Zhongy1/LaserTag/Images/Prototype1/CAD/blaster_print_1.jpg

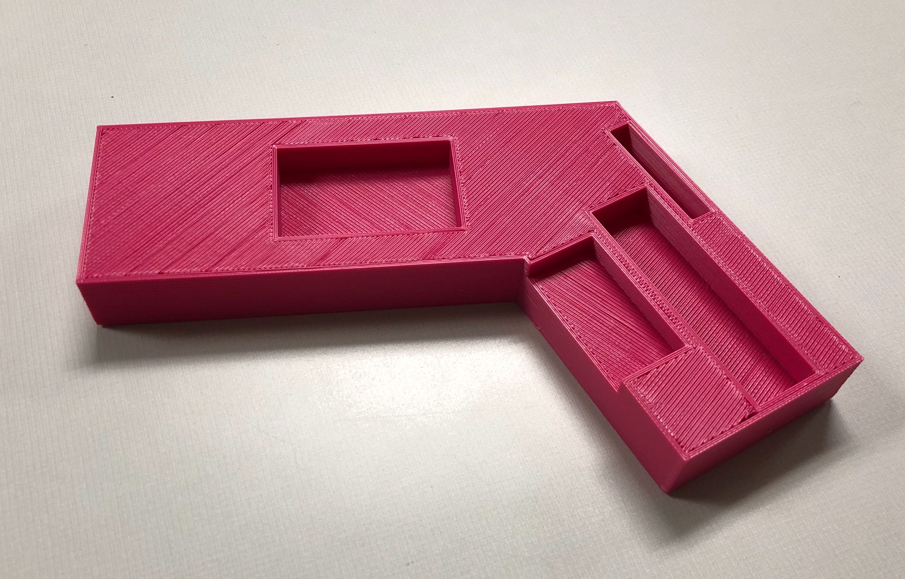
Images/Prototype1/CAD/blaster_print_1.jpg
