Zhongy1/LaserTag/Images/Prototype1/Arduino/wiring.jpg

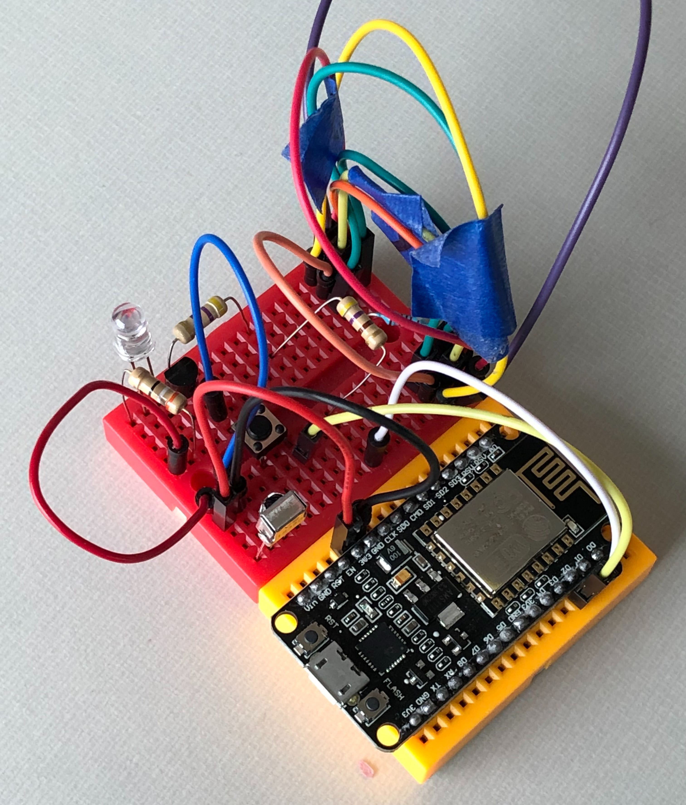
Images/Prototype1/Arduino/wiring.jpg
