Zhongy1/LaserTag/Server/README.md

# Laser Tag Server

> Server component of laser tag system

## Running the server

```bash
# Open a new terminal, install dependencies and run the backend server
$ cd LaserTag/Server/Backend/
$ npm i
$ npm run prod

# Open a new terminal, install dependencies and start serving the frontend
$ cd LaserTag/Server/Frontend/
$ npm i
$ npm run serve
```
