Zhongy1/LaserTag/Server/Frontend/README.md

# Laser Tag Server Frontend

> Web client component of laser tag system

## Project setup
```
npm install
```

### Compiles and hot-reloads for development
```
npm run serve
```

### Compiles and minifies for production
```
npm run build
```

### Customize configuration
See [Configuration Reference](https://cli.vuejs.org/config/).
