Zhongy1/LaserTag/Prototype1/Server/README.md

# LaserTag Server

Laser tag server for scoreboard and game functionality
