Zhongy1/LaserTag/Images/Prototype1/CAD/blaster_half_1.png

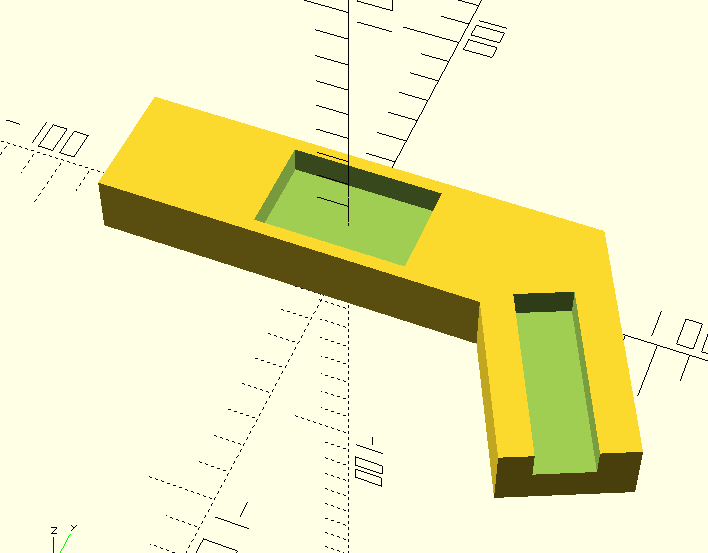
Images/Prototype1/CAD/blaster_half_1.png
