Zhongy1/LaserTag/Images/Prototype1/Circuitry/battery_contacts.jpg

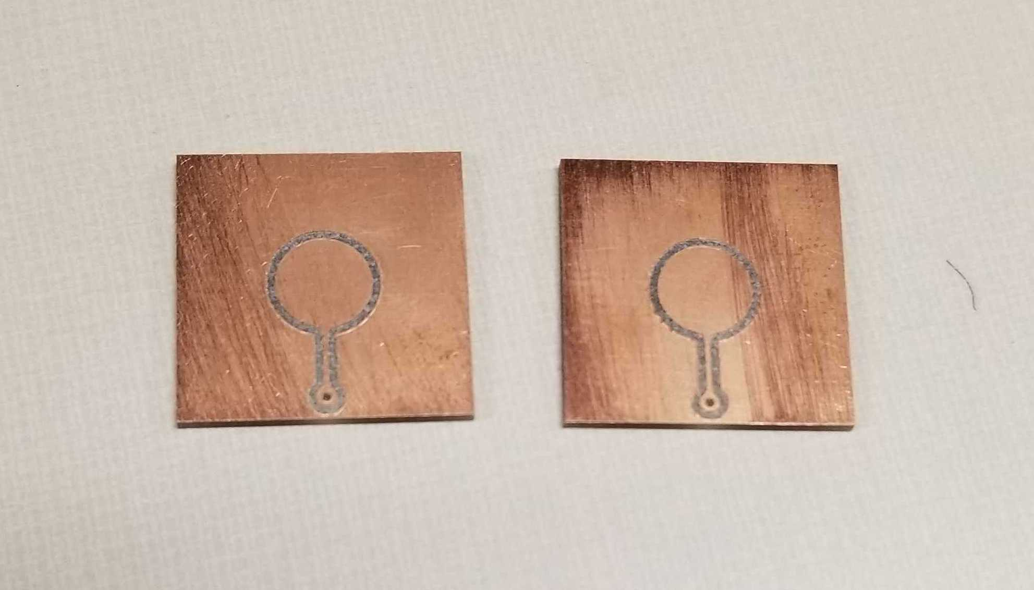
Images/Prototype1/Circuitry/battery_contacts.jpg
