Zhongy1/LaserTag/Images/Prototype1/Circuitry/battery_contacts_boards.jpg

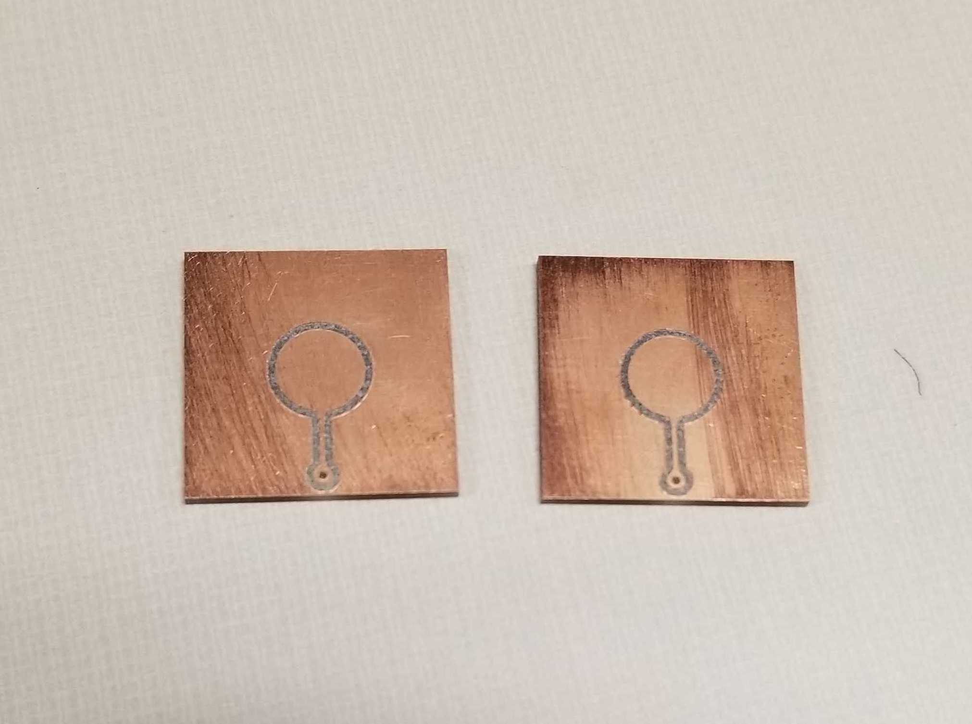
Images/Prototype1/Circuitry/battery_contacts_boards.jpg
