Zhongy1/LaserTag/Images/Prototype1/Circuitry/battery_contacts_design.png

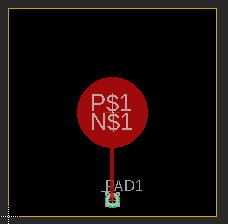
Images/Prototype1/Circuitry/battery_contacts_design.png
