Zhongy1/LaserTag/Images/Prototype1/Circuitry/control_board_bottom.jpg

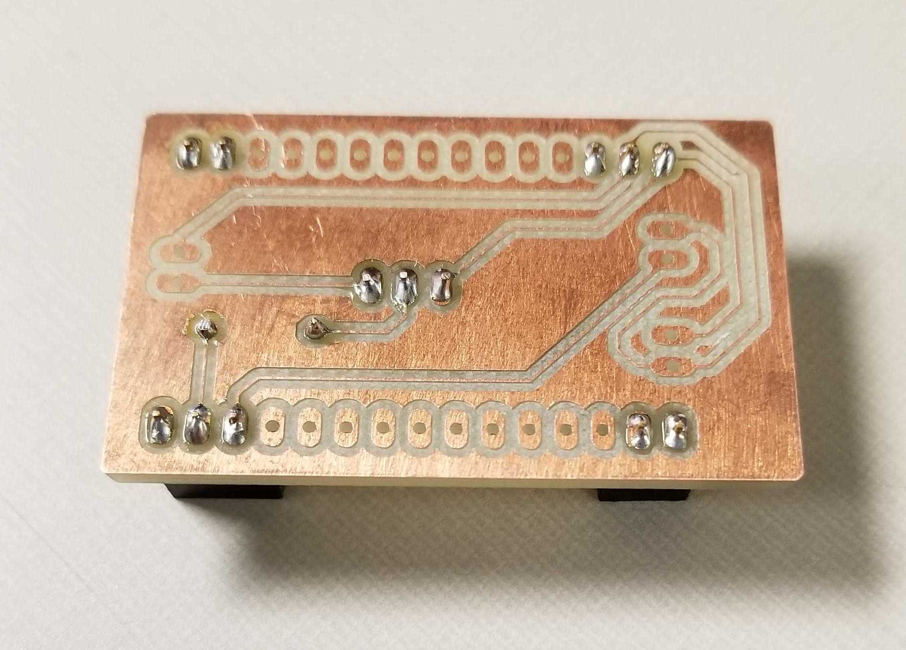
Images/Prototype1/Circuitry/control_board_bottom.jpg
