Zhongy1/LaserTag/Images/Prototype1/Circuitry/control_board_top.jpg

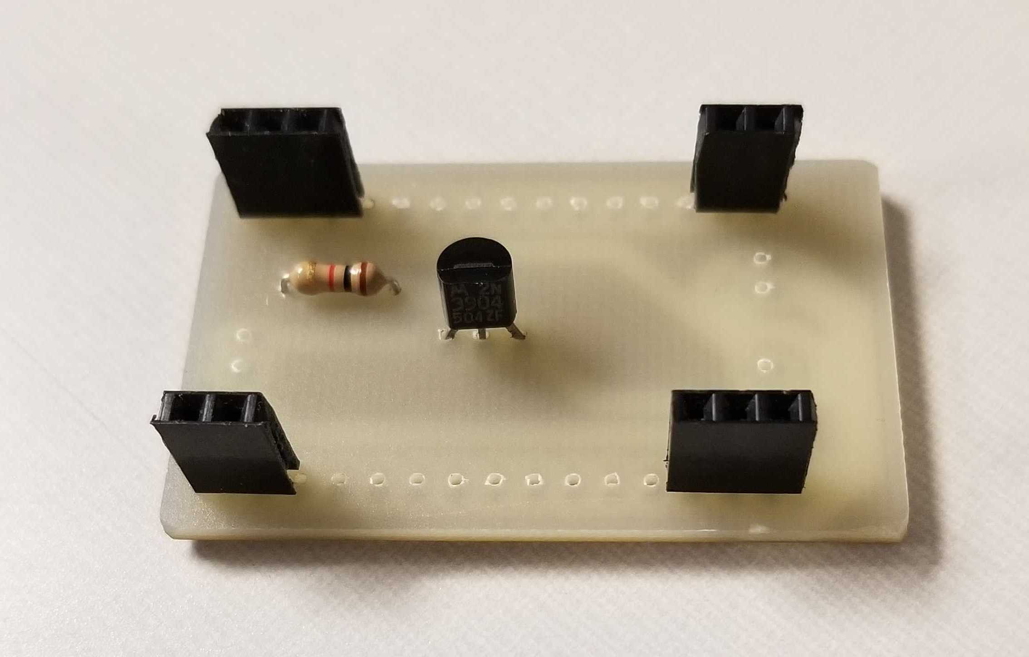
Images/Prototype1/Circuitry/control_board_top.jpg
