Zhongy1/LaserTag/Images/Prototype1/Circuitry/ctrl_board_design.png

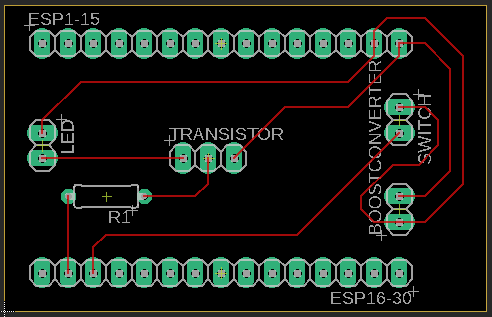
Images/Prototype1/Circuitry/ctrl_board_design.png
