Zhongy1/LaserTag/Images/Prototype1/Circuitry/led_board_design.png

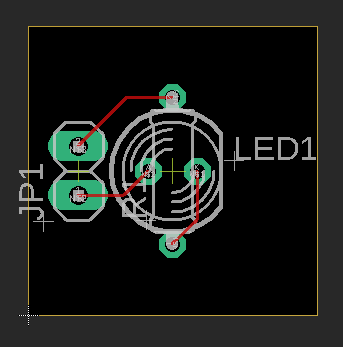
Images/Prototype1/Circuitry/led_board_design.png
