Zhongy1/LaserTag/Images/Prototype1/Circuitry/led_red.jpg

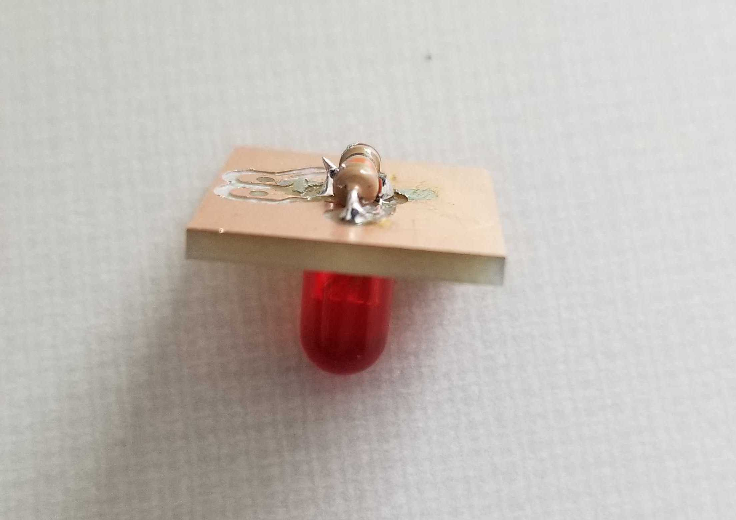
Images/Prototype1/Circuitry/led_red.jpg
