Zhongy1/LaserTag/CAD/LensTachment.scad

use <base_modules.scad>


lensDiam = 19.9 + 0.4;
lensDiamInner = 17.62 + 0.4;

Attachment();
//Attachment([0, -40, 0]);
//Attachment([0, 40, 0]);
*for (i = [0 : 4]) {
    translate([i * 20, 0, 0])
        solid_block([10, 10, 10]);
}

module Attachment(shift = [0, 0, 0], rotation = [0, 0, 0]) {
    translate(shift) { rotate(rotation) {
    
    
    intersection() {
        difference() {
            translate([30, 0, 0])
                //cutout to attatch onto gun
                solid_block([60, 40.43 + 5, 55.29 + 5]);
            translate([5, 0, 2.5])
                solid_block([10, 40.43, 55.29]);
            translate([0, 0, (55.29 + 5)/2])rotate([0, 90,0])
                solid_cylinder([lensDiamInner, lensDiamInner , 60]);
            for (i = [0 : 9]) {
                translate([i * 6 + 12, 0, (55.29 + 5 - lensDiam)/2])
                    //remeasure slit for lens
                    solid_block([1.09 + 0.3, lensDiam, lensDiam]);
            }
        }
        translate([30, 0, 0])
            solid_block([60, 40.43 + 20, (55.29 + 5)/2]);
    }
    
    
    }}
}
