Zhongy1/LaserTag/(threads)

Thread 1 (2019-09-23):

P1 | CAD | Initialize design

Zhongy1, 2019-09-23:
Use hypothetical values to temporarily generate the shape of the blaster as well as hollowed regions where parts will go. Follow the sketch design attached.
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

Zhongy1, 2019-09-30:
Keep in mind that this is just initialization. The placement of objects can be approximated, any rotations for certain items can be ignored, and rectangular or complex cutouts can even be square cutouts near the area it has to be. Focus on just the bottom half of the blaster; see if you can create a simple design presentable at our next team meeting.

Closed 2019-10-28.

Thread 3 (2019-09-25):

P1 | Circuitry | Microcontroller board

Zhongy1, 2019-09-25:
Start working on adding components to microcontroller.sch. Most of the components should just be adding two/three pin holes. For the ESP8266, use two rows of pin holes. For the board file, follow the general layout at the bottom of the image. Don't worry about where things are connected just yet. There may be some syncing issues with the schematic and board file. Message me directly if this is the case.

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

Closed 2019-10-22.

Thread 4 (2019-09-25):

P1 | Arduino | IR LED Test Circuit

Zhongy1, 2019-09-25:
Demonstrate IR LED functionality works with transistor as signal controller.
- Creating IR LED circuit (possibly follow the image attached, use resistor values as shown as well)
- Create receiver circuit to collect the signal from IR LED and verify that it is correctly sending

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

Closed 2019-11-19.

Thread 8 (2019-09-30):

P1 | Arduino | Understanding Websocket

Zhongy1, 2019-09-30:
websocket_example has been added to the Arduino folder. It's a bit short, so figure out what is happening by the end of the week. You do not need to create a branch for this issue since you don't need to modify or add anything. Do some planning on how websocket can be incorporated into the blaster. For example, if IR receiver detects a signal that should be sent to the server, how would you do that?

Thread 12 (2019-10-18):

P1 | CAD | Simplified design

Zhongy1, 2019-10-18:
Assuming that the general cutout regions have been created, it is time to modify the frame and cutout regions using actual values. The goal is to create a design that can house all of the components necessary for a working prototype: microcontroller, IR LED, switch, boost converter, and battery.
- Do not attempt to create detailed cutout regions, that task will done in a future issue.
- Keep cutout regions rectangular.
- You will have to print your design to actually show that everything fits.

Add more variables as needed. These will be filled in/modified overtime when measurements are collected. These variables go into Variables.scad.
Variables: (In millimeters)
- circBrdT = 0; //TBD
- circBrdSolderSpace = 3;
- ledBrdW = 10;
- ledBrdL = 10;
- ledHousingD = 5.4;
- ledHousingH = 0; //TBD
- microCtlrHousingW = 0; //TBD
- microCtlrHousingL = 0; //TBD
- microCtlrHousingH = 0; //TBD
- switchHousingW = 0; //TBD
- switchHousingL = 0; //TBD
- switchHousingH = 0; //TBD
- cnvrtrHousingW = 0; //TBD
- cnvrtrHousingL = 0; //TBD
- cnvrtrHousingH = 0; //TBD
- batteryHousingW = 0; //TBD
- batteryHousingL = 0; //TBD
- batteryHousingH = 0; //TBD

GunPieceBottom:
- create sub-modules for each cutout (i.e ctlrCutout, switchCutout, etc.). Doing this will make adding details easier in the future.
- call the sub-modules here; since the general cutout locations are established, all you might need to do is replace a few lines of code with ctlrCutout, switchCutout, etc.
- you will be using difference() here. Since the first item for difference is the thing you subtract from, use union() to gather pieces together first (i.e the frame of the gun)
- adjust size of gun overtime; use a variable to make changing the size easier if needed
- keep in mind that this is half of the gun, which means you will only be using half the housing heights. The other half of the height goes to GunPieceTop

GunPieceTop:
- If done right, you should be able to use the mirror of GunPieceBottom
- No need to worry about locking the top and bottom together, that can be done in another issue

fdemp, 2019-10-30:
Microcontroller board + ESP8266 has a height of 17.4mm

Closed 2019-12-31.

Thread 13 (2019-10-18):

P1 | Circuitry | Microcontroller board component connections

Zhongy1, 2019-10-18:
Now that all components have been added to the schematic and pieces can be moved around on the board file, it's time to connect everything and cutout a board.

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

Use the general layout of the board from issue #3.
- B: Two wire holes to +/- to boost converter board (B1, B2)
- L: Two wire holes to IR LED board (L1, L2)
- T: Three holes for transistor legs (T1, T2, T3; T2 is the middle hole)
- S: Two wire holes to switch/trigger (S1, S2)
- New R: Two wire holes for resistor (R1, R2)

Since everything is just holes, order does not matter as wire positions can be swapped or transistors can be rotated.
Create the following connections:
- B1 to GND
- B2 to Vin
- L1 to T1
- L2 to GND
- T2 to R1
- R2 to D1/GPIO5 (This is for switching on/off transistor)
- T3 to Vin
- S1 to D2/GPIO4 (This is for detecting pulled trigger)
- S2 to GND

Since there's no circuit drawing this time, there will likely be some confusion. Post questions onto this issue and I will address them. The layout is still similar to drawn layout from #3, but is actually wrong because it did not account for how the microcontroller board will be mounted. The GND and Vin pins are actually mirrored on your board file because the top is where you will solder. Once done, let me know so we can cut the board.

Closed 2019-10-22.

Thread 14 (2019-10-18):

P1 | Arduino | Send IR signals using ESP8266

Zhongy1, 2019-10-18:
It has been demonstrated that sending IR signals from the Arduino Uno works. Now it's time to do the same with the ESP8266. The library used on the Uno is different from the one that will be used for the ESP8266; a little bit of googling will give you an idea of what library to use. Do the following:

Create IR_ESP8266.ino in the Arduino folder; use this file to write the code to test sending/receiving signals.
- Create a function called emitHex which takes a hexadecimal string as input.
  - The only thing this function should do is cause IR LED to emit a signal
  - This function seems unnecessary, but in the future, this function will be modified to take an object/list of information and convert them into hex format to be emitted.
- A microcontroller should be able to both receive and send signals
- Use a transistor to control the LED, as this is what will be in the actual circuit
- An Arduino Uno can still be used as the receiver; to test at a distance

For the prototype, one microcontroller will control the receiving of signals and send information to the server. The other one will be inside the gun and it will control the sending of signals. Both microcontrollers will need to be connected to the server, but for this issue you don't need to worry about doing that. Once everything here works, assume that you will be copying code over to blaster_client and receiver_client.

torashad99, 2019-10-23:
Added IR_ESP8266 file and created function prototype for emitHex function

Zhongy1, 2019-10-25:
Use D1 as sender, D2 as switch, D3 as receiver

Closed 2019-11-19.

Thread 15 (2019-10-18):

P1 | Arduino | Establish Websocket connection

Zhongy1, 2019-10-18:
Connecting ESP8266 to an access point is now possible. Previously, we encountered a problem because ESP8266 can only connect to WPA/WPA2 type access points, but UIC's network is WPA Enterprise. The current solution to this problem is to use a linux machine to create a WPA2 type access point to which the microcontroller will connect to. We will create a file that will focus primarily on communicating with the server.

Create a file called receiver_client.ino in the Arduino folder, this will be the official file to use for the IR receiver microcontroller.
- A lot of the code can already be taken from websocket_example.ino
- Assuming you do use the code from the example, create a function called sendHexToServer which takes a string as an argument
  - For now, this function can execute one line which is to just send a string to the server
  - In the future, some string manipulation may be necessary but you don't need to worry about that

For testing your code, contact me on how to do it. Creating an access point from ArchLinux is really simple, not sure how same that is for other linux operating systems.

Closed 2019-10-25.

Thread 19 (2019-10-29):

P1 | Circuitry | Solder components to microcontroller board

Zhongy1, 2019-10-29:
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

Do the following:
- Solder female header pins to regions marked in red
- Solder a 1K ohm resistor in region marked in green
- Solder a transistor into the region marked in blue, match the legs with the labels

All components should be inserted from the opposite side. Which means there should be no components on the copper side

jmossm2, 2019-10-29:
Soldered the components to the board
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

Closed 2019-10-29.

Thread 20 (2019-10-29):

P1 | Circuitry | LED board

Zhongy1, 2019-10-29:
Create a circuit board that fits a 5mm LED. Use the following schematic as a guide:
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

Create a schematic file called led.sch. Its corresponding board file should automatically be named led.brd.
For the board, use 15mm by 15mm as the dimension; you will be fitting components into a square board. The LED should be centered directly in the middle of the board. Sticking with the metric system, it's coordinates should be at x: 7.5mm and y: 7.5mm. The pin header should be placed at the center of one side. It may be possible to place the resistor directly in the center by overlapping LED and resistor.

Closed 2019-10-29.

Thread 25 (2019-11-01):

P1 | Circuitry | Battery Contacts

Zhongy1, 2019-11-01:
We now have boards for LED and microcontroller. The last boards to work on are the contacts for the battery. The following drawing will give you an idea of what you will be creating.

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

I have added custom_library.lbr to the Circuitry folder. Search up how to add a library to Eagle. In it contains a few things, but you will only be using CONTACT_REGION. This a a circular pad that you can put solder on to form the contacts for the battery. An example of how the board will be laid out is shown in the drawing; it includes the pad as well as a hole for a wire to go through.

The bottom two drawings show where the circuit board will be placed in the holder. You can notice that the width/length of the board will be greater than the diameter of the battery.

For the file name, use battery_contact.

Closed 2019-11-05.

Thread 28 (2019-11-19):

P1 | Circuitry | Microcontroller board connection modifications

Zhongy1, 2019-11-19:
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
The connections specified in issue #13 does not work. Fortunately, this is a simple fix.
Modify microcontroller.sch to reflect these changes:
- LED pin 1 to Vin (ESP1-15 pin 15)
- Transistor pin 3 to GND (ESP1-15 pin 14)

Modify microcontroller.brd to correct the wire paths.

Closed 2019-12-31.

Thread 33 (2020-01-21):

P2 | Circuitry | Battery Insert

Zhongy1, 2020-01-21:
The plan for prototype two is to create a battery case that can attach to or detach from the blaster. Think of this as the magazine for a gun. The purpose of this is to eliminate the need to put a blaster on standby just for it to charge. This task will involve doing some CAD work to create a prototype for the battery insert. Design does not need to look good. Since this is a prototype, show that this idea is actually possible first before planning for actual designs for the battery case.

Battery contacts were created for prototype one. Evaluate if a new design should be used or if any modifications can be made to improve the board. For example, maybe the board could be smaller.

Some other important things:
- You will be doing some wiring; you may need to create wire paths in your CAD design
- Pay attention to short circuits or plugging into wrong terminals; how to avoid setting battery on fire

Components possibly needed:
- tp4056; charge circuit
- boost converter
- male/female header pins

Thread 34 (2020-01-21):

P2 | Circuitry | Battery Charging Station

Zhongy1, 2020-01-21:
Since we are designing detachable battery packs, a charging station would be an ideal complement. Just like the Battery Insert #33, CAD is involved. The station is not necessary for this prototype, but by designing it, it may give insight about how to design the battery socket for the blaster. The station does not have to be big, maybe the first one could just be for one battery.

Components available to use:
- tp4056; charge circuit
- 5 volt power supply

Thread 35 (2020-01-21):

P2 | Circuitry | RGB LED Testing

Zhongy1, 2020-01-21:
To indicate who is in which team, we decided to use RGB LEDs on the side of the blaster. Create boards that could be mounted onto a breadboard for a programmer to use. Each LED will be individually addressable. Multiple shift registers (74hc595) will be used. Start with two; it'll give you an idea on how they can be chained together.

Parts to use:
- Common anode smd 3528 RGB LEDs
- 0805 smd resistors (330 ohms)
- 74hc595 shift register

Notes:
- Common anode LEDs share the same positive connection
  - To set an LED as operational, set this connection to HIGH; LOW otherwise
  - The other connections will be controlled by three pins from the microcontroller, whether or not transistors are needed here will be determined later on. The current output for a pin on ESP8266 is 12ma. Keep in mind that LEDs can take up to 20ma and that the pin current might be shared by all the LEDs on the board.
- The shift register we are using can supply HIGH output to 8 LEDs
- In total, 6 microcontroller pins are needed to ideally control any number of LEDs
- This will most definitely by a double sided board

Thread 36 (2020-01-23):

P2 | NodeJS | Back and Front End Implementation

Zhongy1, 2020-01-23:
Now that a prototype for a blaster as well as a basic sensor node is ready and usable, all features for the server can be implemented with minimal reliance on the other sub teams.
This is the list features to implement server side:
- Waiting room
- Game rooms
- Teams
- Scoring System / Kill counter
- Game time tracker

This is the list of features to implement web client side:
- Waiting room display
- Game room creator
- Team selector
- Game stats display

Connecting microcontrollers:
Two types of nodes will be connecting directly to the server: blaster and sensor vest. Each node will have it's own unique ID preset to something of our choosing. Example: "B01" or "B02" for blaster and "S01" or "S02" for sensor vest. These ID's will be shown in the web client to allow easy placement into teams. Immediately upon joining, nodes will be placed into the main waiting room where they will become visible in the front end.

The following are more details on each of the features. Will include possible implementation and what kind of properties might be needed if a class should be made.

**Nodes**
Create a general class for a node; as well as two more classes for blaster and sensor vest which will extend off the this class. Common properties may be ID or a companion ID to indicate which node it should be associated with. Blaster/vest node can include a set function which ensures that companion ID can only be "S" or "B" respectively. One more possible common property could be a reference to the websocket the node is associated with (more about this later, ask me about this part).

**Waiting Room**
Class with possible property to include: nodes list, could be an array or a mapping that can hold both blaster and vest.

**Game Room**
Class with possible properties: room ID, list of Team objects. When moving a node into a game room, decide on what may be best. Have nodes auto join first available team initially? Have each node be put into a new team upon joining? Should a room size be used? Maybe a property to enable/disable free for all?

**Teams**
Class with possible properties: blaster/vest node list (separate?), team color in HEX. Team color will be given to blaster to set RGB LED colors. Vest nodes will not need the color. They will process attacks from blasters and it will be for the server to decide if target is eliminated or not if on same team. Purpose for this is sensors may pick up incorrect signals maybe from the game environment and end up disabling itself when it's not supposed to. The server should check that the attacker actually exists in the same game room.

**Scoring System**
This could be incorporated into game room functionality. Property to add then include most kills (and by who). Other stats to track could be decided later.

**Game Time Tracker**
Not really needed/important, but it'd be nice to keep track of how long game is running. Could be implemented in Game Room.

**Front End**
Figure out a way to layout the webpage to display the information about the server. I highly suggest using websockets for this to provide webpage with live updates. I can teach you how websockets work if needed.

**Node communication with server**
Before we were using commands sent over websocket to do various things. I still think this is a good idea. Blasters will likely not be sending any information to server besides ID. Only the vest nodes will be sending data in a command of this format: `/attack <attacker> <victim>`. Example: `/attack B01 S02' which means blaster with ID 'B01' attacked vest with ID 'S02'. Some other things to look out for...

Not okay (considered invalid and will be ignored):
- `/attack S01 S02` Vest attacking vest
- `/attack B01 B02` Blaster attacking blaster
- `/attack S01 B02` Vest attacking blaster
- Blaster attacking vest of same player; check companion ID of blaster node

May not be okay (could be invalid; depends on if ID exists):
- `/attack B74 S01` B74 is suspiciously big, but if it exists in game room then attack is valid

Connect command format:
- `/connect <node-id>` Create a new node object of type blaster/vest using the provided ID

Thread 40 (2020-01-27):

P2 | CAD | Lens Testing Attachment

Zhongy1, 2020-01-27:
For prototype one, we did not use a lens with our IR LED. We want to design a module that can be attached to prototype one to test IR LED with lens.

Closed 2020-03-09.

Thread 41 (2020-01-28):

P2 | Arduino | Send Raw IR Signals

Zhongy1, 2020-01-28:
Currently prototype one sends an NEC signal. This can potentially interfere with LG TV's. We would like to use the send raw signal functionality built into the same IREsp8266 library. Create a new Arduino file that can be uploaded to the prototype blaster to test outputting raw signals. To receive, one of the examples for receiving signals that comes with the library should work.

Thread 42 (2020-01-28):

P2 | Arduino | Ammo Tracking Functionality

Zhongy1, 2020-01-28:
We had planned to implement ammo functionality for a while. This is the time to do that. For now we can hard code how much ammo is in a blaster. Maybe 8 is a good number. Each time the trigger is pulled, --ammo--++. There also needs a delay before the next shot can be made. Avoid using Arduino's delay function as that prevents other functionalities from running. To reload, hold down the trigger for 3 seconds. After three seconds, the blaster is reloaded and can output IR signals once again.

awoo8, 2020-02-18:
This is also addressed in #52 and is completed in #54

Closed 2020-02-18.

Thread 49 (2020-02-03):

P2 | CAD | Round Out Blaster

Zhongy1, 2020-02-03:
Currently prototype one is just a block. It's very uncomfortable to hold. We want to round out the edges for prototype two. Create a mock file to represent just the potential shape of prototype two. This means you can use arbitrary values instead of the values from variables.scad. Finally, design this such that it is lying on its side just like prototype one.

Call this file p2shape.scad.

Thread 51 (2020-02-11):

P2 | Circuitry | Control Board

Zhongy1, 2020-02-11:
New pins used:
Trigger -> D0
Oled SCL Pin -> D1
Oled SDA -> D2
Infrared LED -> D3
Shift Register Data Pin (14) -> D4
Shift Register Clock Pin (12) -> D5
Shift Register Latch Pin (11) -> D6
LED Red Control -> D7
LED Green Control -> D8
LED Blue Control -> TX
Battery Checker -> A0

This prototype we will be using the majority of the pins on the ESP8266. Features we will support are infrared output, trigger pull detection, OLED display, LED light display, battery checking. This means we will need to create test cases for each of these features...
- Trigger and infrared LED. (Only the pins changed, so could possibly modify an exiting test case)
- Reload functionality
- OLED (Write letters and/or numbers on screen)
- Shift register and various color test
- Battery checker
There will be issues for each of these. More information will be on each of those issues.

The creation of the main board will depend on how things turn out in each of the test cases. For example, guides online advise us to use pull up resistors on the SCL/SDA pins. May or not be necessary; if it works without resistors then we won't add resistors. Some other various things to include:
- resistor for a transistor
- resistor(s) for IR LED (SMD resistor)
- resistors for red/green/blue control pins (SMD resistors)
- resistor for battery checking (maybe)

Closed 2020-03-03.

Thread 53 (2020-02-17):

P2 | CAD | Initialize Individual Files

Zhongy1, 2020-02-17:
For prototype one, we created modules for led, main board, battery, etc. all inside prototype1.scad. For prototype two, we will create individual files for each of these modules.

The list of files to create:
- ledCutout.scad
- boostConverter.scad
- controlCutout.scad
- batteryCutout.scad
- switchCutout.scad

The files should follow this format:
```
include <variables.scad>
use <base_modules.scad>

module someComponent(offset = ...) {
    //...
}
```
The first two lines of code should be the same in every file.
For the module, copy and paste the corresponding module from prototype1.scad into each of the files.

Closed 2020-03-09.

Thread 58 (2020-02-24):

P2 | CAD | Wirepaths

Zhongy1, 2020-02-24:
The problem with wire paths in prototype one was that the paths were too narrow. Sometimes wires have to be bent really hard to fit them into modules. That can't really be helped because we spent very little time on them. This time, spend some time to plan/create a module that can help use add wire pathways.

Create a module in base_modules.scad. Call this module wire_path which includes these parameters:
- starting (x, y) coordinate
- ending (x, y) coordinate
- width
- height

Once you have the starting coordinate, set this to be the origin, which means change it to (0, 0). Whatever math computation you did to the starting point you should also do to the ending point.

To create the module, use solid_block with a width of sqrt(x^2 + y^2). And then use rotation to rotate to the end coordinate. You will be rotating on the z-axis to reach the end coordinate. For calculating the angle to rotate, use atan(opp/adj). If the end coordinate's x value is negative, add 180 to the rotation. Last thing is to translate this in the negative z-axis by half the height.

Thread 59 (2020-02-25):

P2 | Circuitry | Shift Register Board

Zhongy1, 2020-02-25:
Since there is not enough room on the main control board to fit shift registers on it, another control board will be created just for the shift registers. We will be using two shift registers to control a total of sixteen RGB LEDs. The LEDs will be a component separate from this board which means sixteen wire holes will need to be used. These holes should be at the edge of the board: half on one side, half on the other. Three more holes will be needed for controlling the shift registers. You can choose to place these holes near the center of the board or on one of the remaining edges. Try to make this board as small as possible. Following this implementation should result in a board with two shift registers on one side of the board; one shift register will be pointing up and the other will be pointing down.

Summary:
- 2 smd shift registers
- 8 holes on two opposite sides (total of 16)
- 3 holes to control shift registers
- 2 more holes for vcc/gnd

Closed 2020-03-03.

Thread 60 (2020-02-25):

P2 | Arduino | OLED Experimentation

Zhongy1, 2020-02-25:
For prototype two we are using an OLED to display ammo. We also want to display the ID of the blaster to identify the player on the user interface. This will be the first attempt at experimenting with an OLED screen. There are existing libraries that simplify the communication process between microcontroller and screen.

Do the following:
- Create an arduino file called oledTester
- There will be no input; just power on and display letters/numbers
- Display some letters
- Display some numbers
- Try doing various font-sizes of numbers/letters

Components needed:
- OLED screen
- 10K pull up resistors x2

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

Thread 61 (2020-02-25):

P2 | Arduino | Shift Register Testing with RGB LEDs

Zhongy1, 2020-02-25:
In issue #35, we created a shift register board that allows us to use three pins to control red/green/blue value of an LED, and an additional three to control a shift register. Use this created board to write a test program for individually controlling RGB LEDs.

Create an arduino file called rgbShiftTest and do the following:
- Use these pins:
  - Shift Register Data Pin (14) -> D4
  - Shift Register Clock Pin (12) -> D5
  - Shift Register Latch Pin (11) -> D6
  - LED Red Control -> D7
  - LED Green Control -> D8
  - LED Blue Control -> TX
- There are lots of guides online on how to use the 74hc595 shift register. Look them up.
- Since we have 8 leds on the board, create a program that lights up all the LEDs up at once to show all the colors of the rainbow as well as white for the last LED.
- This might be a bit complex, please ask for help or come to my office hours (3-6 wednesday/friday)

Parts used:
- Board created by issue #35

Closed 2020-03-10.

Thread 62 (2020-02-25):

P2 | Arduino | Battery Tracker Tester

Zhongy1, 2020-02-25:
The esp8266 has one analog pin (A0) that can potentially be used to track the voltage of the battery we will be using to power our blaster.

Create an arduino file called batteryTester, and do the following:
- Use an 18650 battery to power on microcontroller
- Write a program that does an analogRead on the battery
- Since we used a boost converter to boost voltage, we may need to use that too

Parts needed:
- 18650 battery
- boost converter (maybe)

This will be your first issue, so I will work with you on this

bli698, 2020-02-27:
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
Still need to find MAX and MIN of the battery.

Thread 64 (2020-03-03):

P2 | Circuitry | Individual RGB LED Board

Zhongy1, 2020-03-03:
In issue #35,  we created a working test board to control LEDs on different color settings. Since we are embedding LEDs on different places on the blaster, we want to design a board for each LED, allowing LEDs to be moved around easily.

Create a board that supports the following:
- RGB LED in the center
- 2 wire pins on opposite sides (total of 4 pins for the 4 contacts on the LED)
- Make this as small as possible: the two sides that have no holes should be as close to the LED as possible

Closed 2020-03-03.

Thread 70 (2020-03-09):

P2 | CAD | Control Module

Zhongy1, 2020-03-09:
We now have a file called controlCutout in the CAD folder. Our main control board is ready for measuring. Measure out the new dimensions for this board including the necessary tolerances for the part to fit into an enclosed space.

Do the following:
- Measure new dimensions/tolerances and update variables file
- Modify controlCutout to include a testable print just like in lenstachment. This is to prevent help conserve print material in case we mess something up.
- In prototype one, we had positioned the control board horizontally. This time, see if it's possible to allow for the board to be mounted vertically. The wording here may be a bit confusing, ask me if you have more questions

Thread 78 (2020-03-24):

P2 | CAD | Place Components onto Prototype 2

Zhongy1, 2020-03-24:
As the title suggests, place components onto prototype 2. Modify prototype2.1.scad file to add the following components:
- IR LED
- Microcontroller board
- shift register board
- boost converter
- prototype 1's battery (place holder)
- prototype 1's trigger (place holder)
- try using the wirepaths modules that was created a while ago

Thread 79 (2020-04-02):

P2 | NodeJS | Create Game Room

FestiveAkp, 2020-04-02:
Create a new TypeScript class inside of `server/models/GameRoom.ts`. This class will represent a laser tag game room, where players can join and start playing. Players will communicate with the game room by emitting NodeJS events which are captured by the room itself and handled appropriately.

Most of the room logic is already defined by `WaitingRoom`, so we can extend that to inherit all of the functionality of holding players and moving them in and out.

For this prototype, we can assume there will only be one game going on at a time, so `ServerController` will hold a single instance of `GameRoom`.

We can also assume that there will be only be two teams playing against each other in a typical game, so `GameRoom` must have the ability to define two teams, add and remove players from a team, and so on. In the future we can also create a free-for-all mode where there aren't any teams.

The game room must also keep track of each player's score (maybe we can do # of kills for now) so that the front end can display a scoreboard during the game.

Closed 2020-04-07.
