Zhongy1/LaserTag/Circuitry/chainable_shift_register.brd

## EAGLE design Circuitry/chainable_shift_register.brd (2020-03-03)

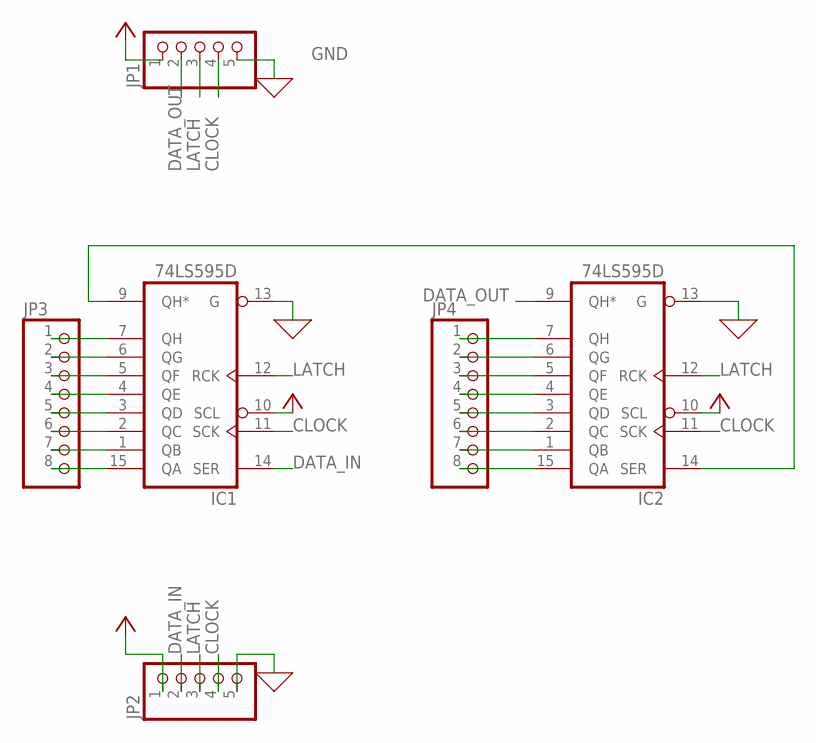
[picture p12: schematic chainable_shift_register.sch]

Parts:
IC1, IC2: 74LS595D; SO16
JP1, JP2: PINHD-1X5; 1X05
JP3, JP4: PINHD-1X8; 1X08

Connections:
CLOCK: IC1.11 (SCK), IC2.11 (SCK), JP1.4, JP2.4
DATA_IN: IC1.14 (SER), JP2.2
DATA_OUT: IC2.9 (QH*), JP1.2
GND: IC1.8 (GND), IC1.13 (G), IC2.8 (GND), IC2.13 (G), JP1.5, JP2.5
LATCH: IC1.12 (RCK), IC2.12 (RCK), JP1.3, JP2.3
unnamed: IC2.15 (QA), JP4.8
unnamed: IC2.1 (QB), JP4.7
unnamed: IC2.2 (QC), JP4.6
unnamed: IC2.3 (QD), JP4.5
unnamed: IC2.4 (QE), JP4.4
unnamed: IC2.5 (QF), JP4.3
unnamed: IC2.6 (QG), JP4.2
unnamed: IC2.7 (QH), JP4.1
unnamed: IC1.7 (QH), JP3.1
unnamed: IC1.6 (QG), JP3.2
unnamed: IC1.5 (QF), JP3.3
unnamed: IC1.4 (QE), JP3.4
unnamed: IC1.3 (QD), JP3.5
unnamed: IC1.2 (QC), JP3.6
unnamed: IC1.1 (QB), JP3.7
unnamed: IC1.15 (QA), JP3.8
unnamed: IC1.9 (QH*), IC2.14 (SER)
VCC: IC1.10 (SCL), IC1.16 (VCC), IC2.10 (SCL), IC2.16 (VCC), JP1.1, JP2.1

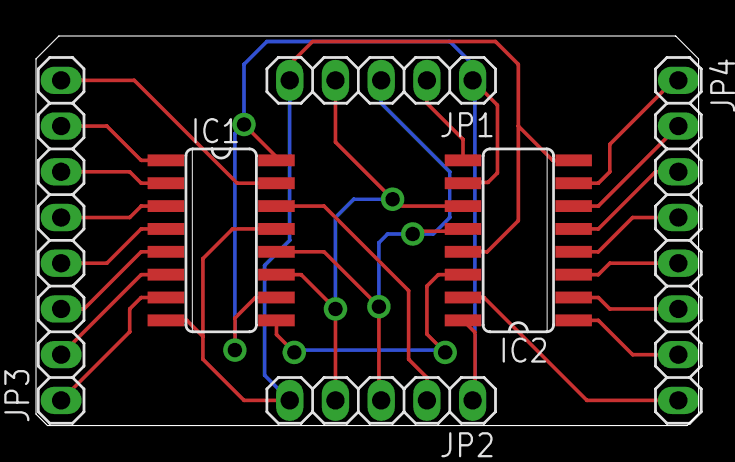
[picture p13: board chainable_shift_register.brd from above]

Board: 2 copper layers, 36.8 x 21.6 mm, 6 parts (0 on the bottom side), 23 nets.
