Zhongy1/LaserTag/Circuitry/Single_RGB_Board.brd

## EAGLE design Circuitry/Single_RGB_Board.brd (2020-03-03)

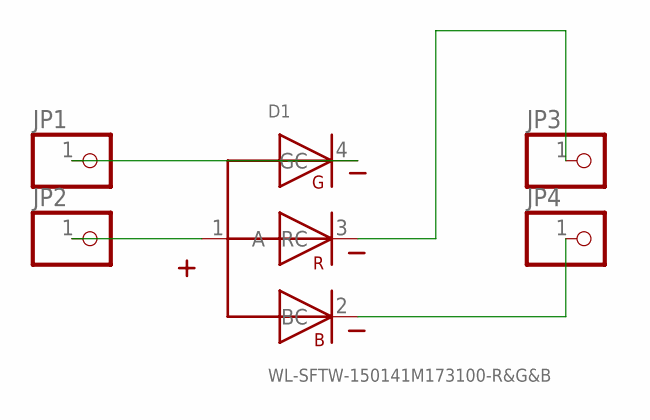
[picture p14: schematic Single_RGB_Board.sch]

Parts:
D1: WL-SFTW-150141M173100-R&G&B; 3528-COMMON-ANODE
JP1, JP2, JP3, JP4: PINHD-1X1; 1X01

Connections:
unnamed: D1.4 (GC), JP1.1
unnamed: D1.1 (A), JP2.1
unnamed: D1.3 (RC), JP3.1
unnamed: D1.2 (BC), JP4.1

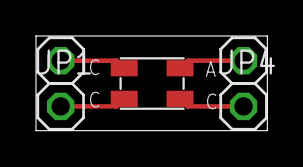
[picture p15: board Single_RGB_Board.brd from above]

Board: 2 copper layers, 12.9 x 5.3 mm, 5 parts (0 on the bottom side), 4 nets.
