Zhongy1/LaserTag/Circuitry/microcontroller.brd

## EAGLE design Circuitry/microcontroller.brd (2020-03-03)

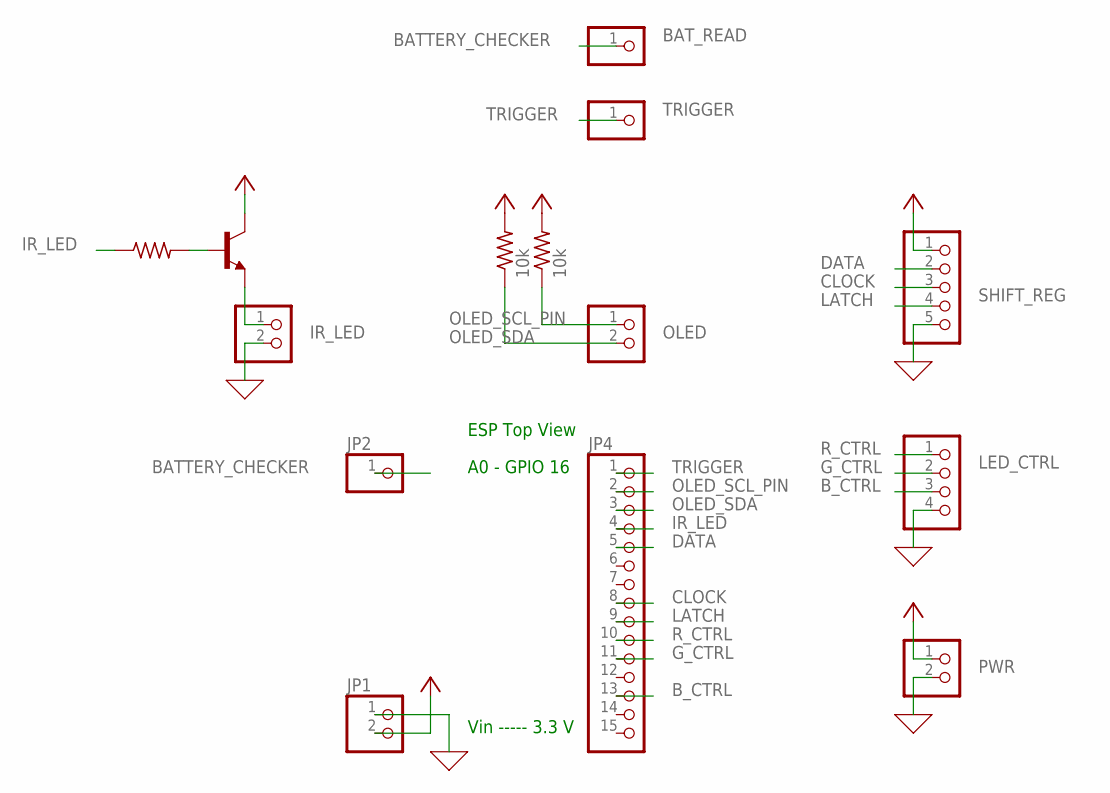
[picture p16: schematic microcontroller.sch]

Parts:
BAT_READ: PINHD-1X1; 1X01
IR_LED: PINHD-1X2; 1X02
IR_TRS: 2N5088; TO92
JP1: PINHD-1X2; 1X02
JP2: PINHD-1X1; 1X01
JP4: PINHD-1X15; 1X15
LED_CTRL: PINHD-1X4; 1X04
OLED: PINHD-1X2; 1X02
PWR: PINHD-1X2; 1X02
R1, R2: 10k; 0204/7
R3: R-US_0204/7; 0204/7
SHIFT_REG: PINHD-1X5; 1X05
TRIGGER: PINHD-1X1; 1X01

Connections:
0: IR_LED.2, JP1.1, LED_CTRL.4, PWR.2, SHIFT_REG.5
BATTERY_CHECKER: BAT_READ.1, JP2.1
B_CTRL: JP4.13, LED_CTRL.3
CLOCK: JP4.8, SHIFT_REG.3
DATA: JP4.5, SHIFT_REG.2
G_CTRL: JP4.11, LED_CTRL.2
IR_LED: JP4.4, R3.1
LATCH: JP4.9, SHIFT_REG.4
unnamed: IR_LED.1, IR_TRS.3 (E)
unnamed: IR_TRS.2 (B), R3.2
OLED_SCL_PIN: JP4.2, OLED.1, R1.1
OLED_SDA: JP4.3, OLED.2, R2.1
R_CTRL: JP4.10, LED_CTRL.1
TRIGGER: JP4.1, TRIGGER.1
VCC: IR_TRS.1 (C), JP1.2, PWR.1, R1.2, R2.2, SHIFT_REG.1

Notes on the sheet:
ESP Top View
A0 - GPIO 16
Vin ----- 3.3 V

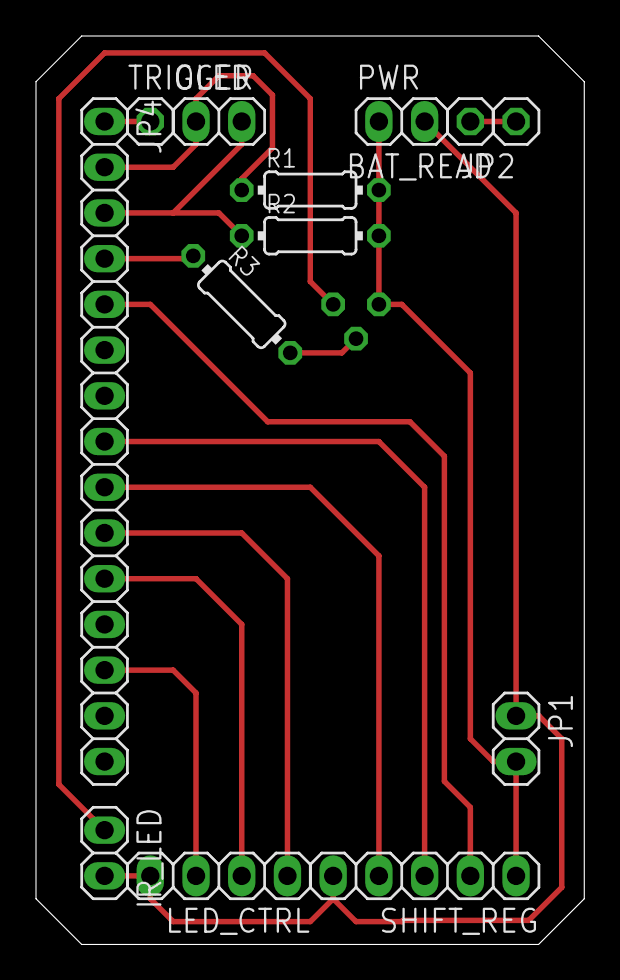
[picture p17: board Circuitry/microcontroller.brd from above]

Board: 2 copper layers, 30.5 x 50.5 mm, 14 parts (1 on the bottom side), 15 nets.
