Zhongy1/LaserTag/Prototype1/Circuitry/led.brd

## EAGLE design Prototype1/Circuitry/led.brd (2019-10-29)

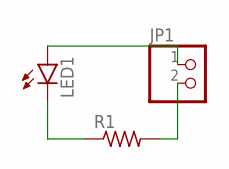
[picture p18: schematic led.sch]

Parts:
JP1: PINHD-1X2; 1X02
LED1: LED5MM
R1: R-US_0207/7; 0207/7

Connections:
unnamed: LED1.K (C), R1.1
unnamed: JP1.1, LED1.A
unnamed: JP1.2, R1.2

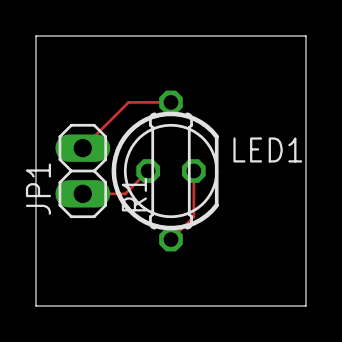
[picture p19: board led.brd from above]

Board: 2 copper layers, 15.0 x 15.0 mm, 3 parts (0 on the bottom side), 3 nets.
