Zhongy1/LaserTag/Prototype1/Circuitry/microcontroller.brd

## EAGLE design Prototype1/Circuitry/microcontroller.brd (2019-12-31)

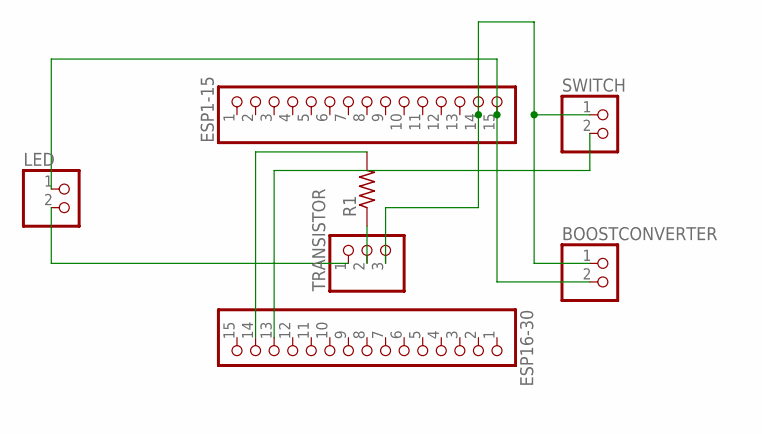
[picture p20: schematic microcontroller.sch]

Parts:
BOOSTCONVERTER: PINHD-1X2; 1X02
ESP1-15, ESP16-30: PINHD-1X15; 1X15
LED: PINHD-1X2; 1X02
R1: R-US_0207/7; 0207/7
SWITCH: PINHD-1X2; 1X02
TRANSISTOR: PINHD-1X3; 1X03

Connections:
unnamed: BOOSTCONVERTER.1, ESP1-15.14, SWITCH.1, TRANSISTOR.3
unnamed: BOOSTCONVERTER.2, ESP1-15.15, LED.1
unnamed: R1.1, TRANSISTOR.2
unnamed: ESP16-30.14, R1.2
unnamed: ESP16-30.13, SWITCH.2
unnamed: LED.2, TRANSISTOR.1

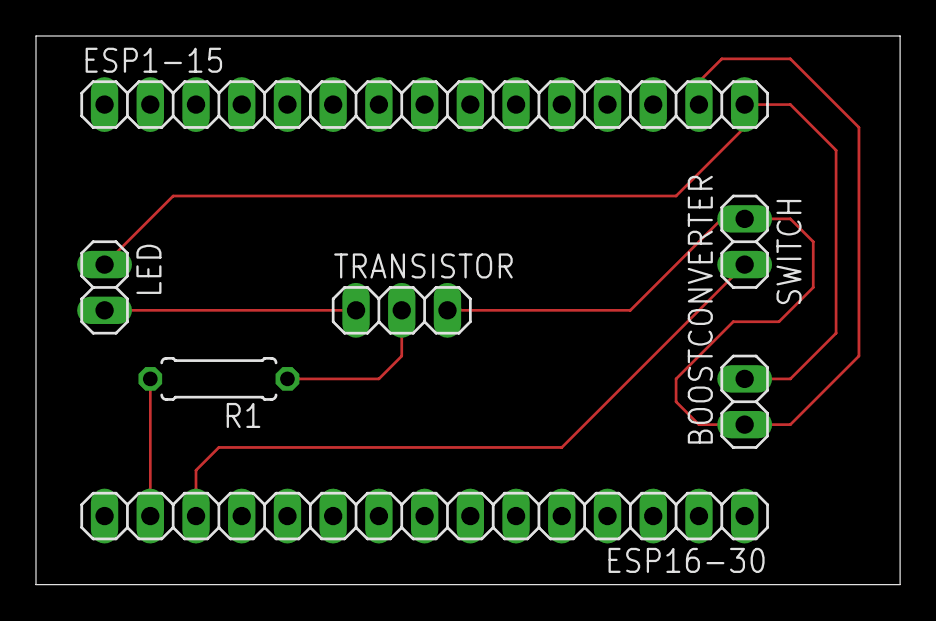
[picture p21: board Prototype1/Circuitry/microcontroller.brd from above]

Board: 2 copper layers, 48.0 x 30.5 mm, 7 parts (0 on the bottom side), 6 nets.
