Zhongy1/LaserTag/Arduino/blaster_client/blaster_client.ino

#include <Arduino.h>
#include <Blaster.h>

void setup() {
  // put your setup code here, to run once:
}

void loop() {
  //handleColorDetails()

  //handleTriggerAndOutput()
  
  //handleScreenUpdate()

  //handleBatteryCheck()

  //handleServerCommunication()
}
