Zhongy1/LaserTag/(commit log)

2019-09-19 Init subgroup folders/files
    [microcontroller.brd, microcontroller.sch]
2019-10-07 init frame
    [prototype1.scad]
2019-10-22 add connections between components
    [microcontroller.brd, microcontroller.sch]
2019-10-23 Added IR_ESP8266 file and created function prototype for emitHex function
2019-10-25 Add existing file
    [prototype1.scad]
2019-10-25 battery cutout
    [prototype1.scad]
2019-10-29 add a board for an led
    [led.brd, led.sch]
2019-11-05 place contacts onto board, no dimensions
    [battery_contact.brd, battery_contact.sch]
2019-11-05 adjust board dimensions
    [battery_contact.brd]
2019-11-07 more changes to design
    [prototype1.scad, variables.scad]
2019-11-15 led is all thats left
    [prototype1.scad, variables.scad]
2019-11-15 need to measure LED
    [prototype1.scad]
2019-11-15 led cutout
    [prototype1.scad, variables.scad]
2019-11-18 add batter contacts
    [prototype1.scad, variables.scad]
2019-11-21 fix the microcontroller board
    [microcontroller.brd, microcontroller.sch]
2019-11-21 move pieces around
    [prototype1.scad, variables.scad]
2019-11-21 resolve merge conflicts
    [prototype1.scad]
2019-11-22 add wire paths
    [prototype1.scad, variables.scad]
2020-01-27 save prototype 1 files
    [battery_contact.brd, battery_contact.sch, led.brd, led.sch, microcontroller.brd, microcontroller.sch, prototype1.scad, variables.scad]
2020-01-27 start attachment design
2020-02-03 save file changes
    [LensTachment.scad]
2020-02-03 add base modules for cad
    [base_modules.scad]
2020-02-03 actually save file for lenstachment
    [base_modules.scad]
2020-02-10 create first test print for lenstatchment
    [LensTachment.scad]
2020-02-11 add initial components and header pins to board
    [microcontroller.brd, microcontroller.sch]
2020-02-17 adjust measurements
    [housing.scad]
2020-02-24 init files
    [batteryCutout.scad, boostConverter.scad, controlCutout.scad, ledCutout.scad, swtichCutout.scad]
2020-02-24 file changes
    [batteryCutout.scad, boostConverter.scad, controlCutout.scad, ledCutout.scad, swtichCutout.scad]
2020-03-03 create microcontroller board
    [microcontroller.brd, microcontroller.sch]
2020-03-03 create chainable shift register board
    [chainable_shift_register.brd, chainable_shift_register.sch]
2020-03-03 remove header pins
    [microcontroller.brd, microcontroller.sch]
2020-03-03 create single rgb board
    [Single_RGB_Board.brd, Single_RGB_Board.sch]
2020-03-04 wire paths
    [base_modules.scad]
2020-03-05 redo measurements to fit
    [LensTachment.scad]
2020-03-10 created an rgb shift tester for 8 leds
2020-03-17 Changed the Structure of Files For Arduino
2020-04-07 Update class diagram and add flow diagram
