Zhongy1/LaserTag/(notices)

Notices in the files:
parts and their libraries:
Wurth_Elektronik_Optoelectronics_rev15b: Copyright: Würth Elektronik
